jbagnara/wheatboard/README.md

# wheatboard

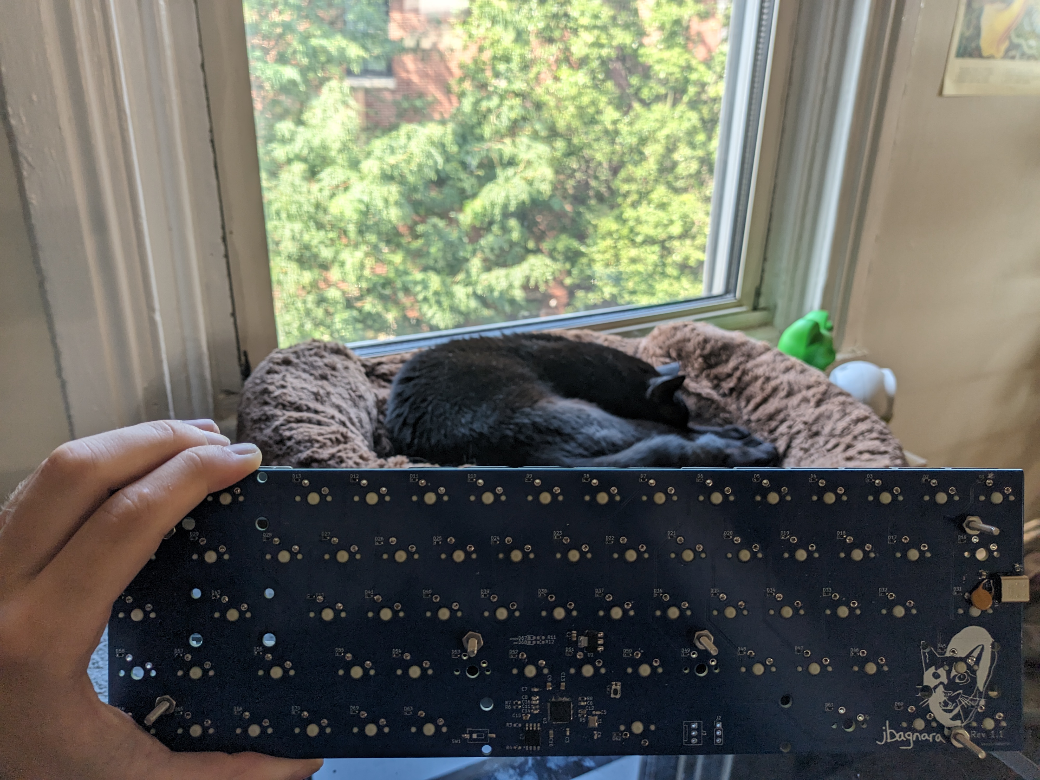
[picture p1: img/img0.jpg]

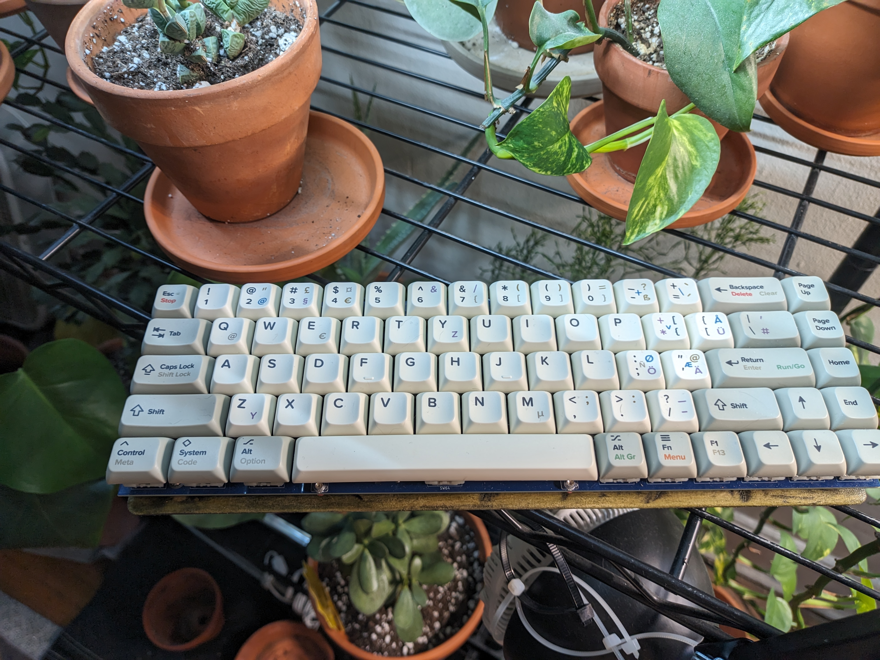
[picture p2: img/img3.jpg]

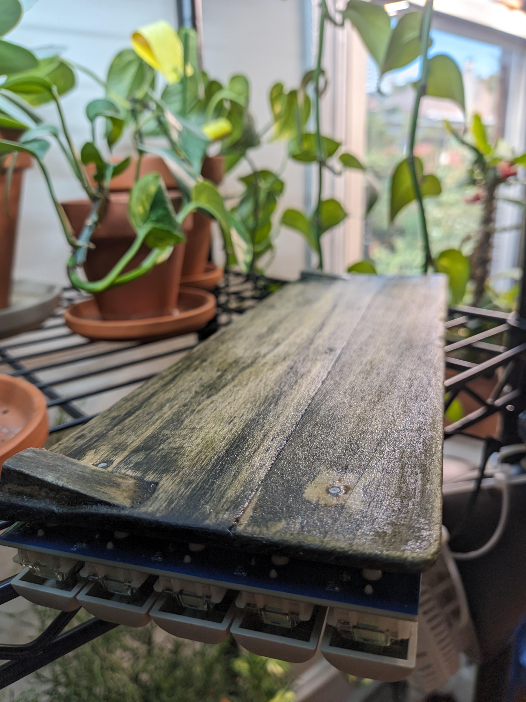
[picture p3: img/img2.jpg]

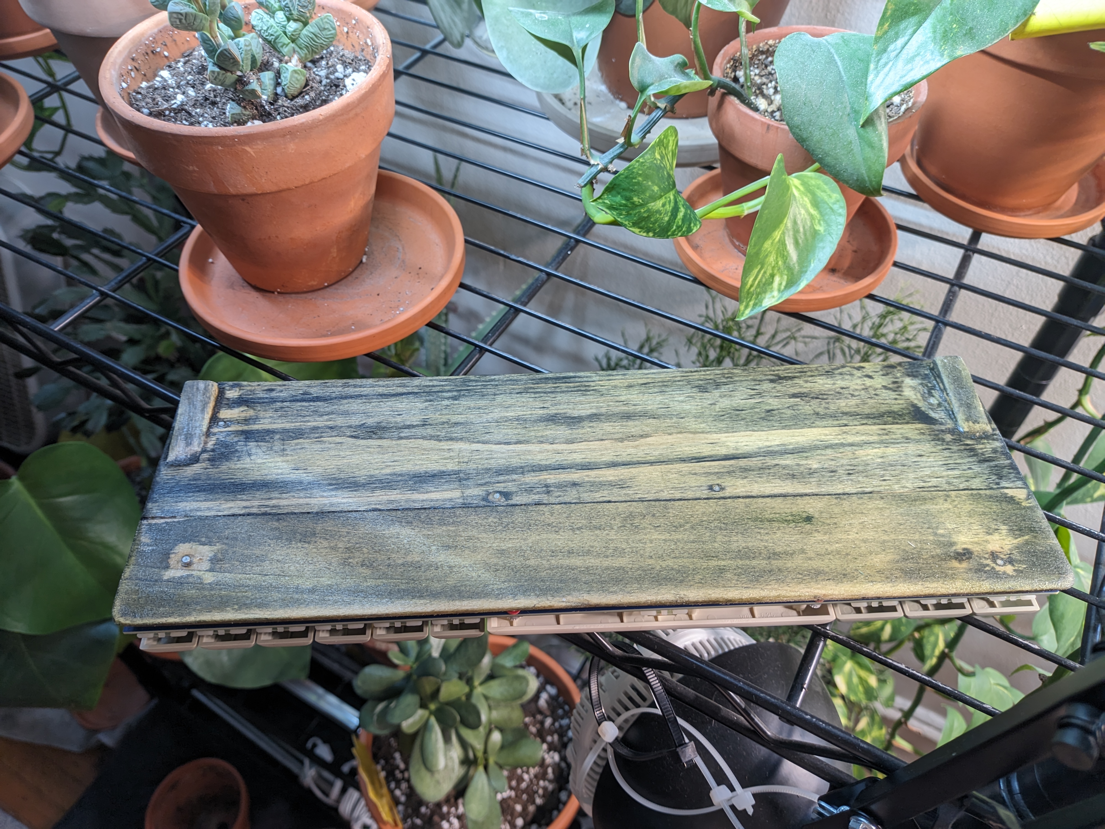
[picture p4: img/img4.jpg]
