jbagnara/wheatboard/kicad/keyboard.kicad_pcb

## KiCad design kicad/keyboard.kicad_pcb (2025-07-31)

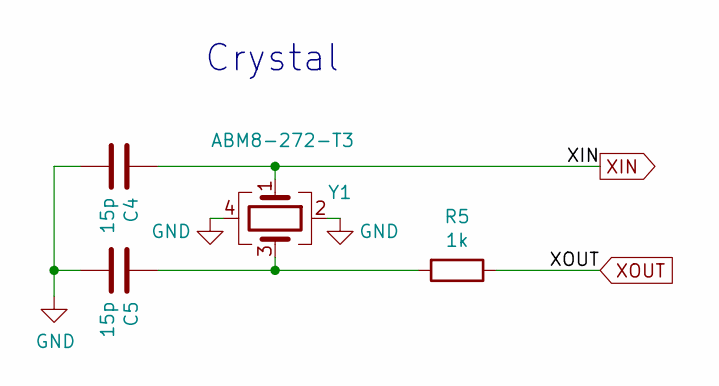
[picture p6: schematic oscillator.kicad_sch]

Parts:
C4, C5: 15p; C_0603_1608Metric
R5: 1k; R_0603_1608Metric
Y1: ABM8-272-T3; Crystal_SMD_3225-4Pin_3.2x2.5mm

Connections:
GND: C4.2, C5.2, Y1.2, Y1.4; also elsewhere on the board
unnamed: C5.1, R5.2, Y1.3
XIN: C4.1, Y1.1; also elsewhere on the board
XOUT: R5.1; also elsewhere on the board

Notes on the sheet:
Crystal

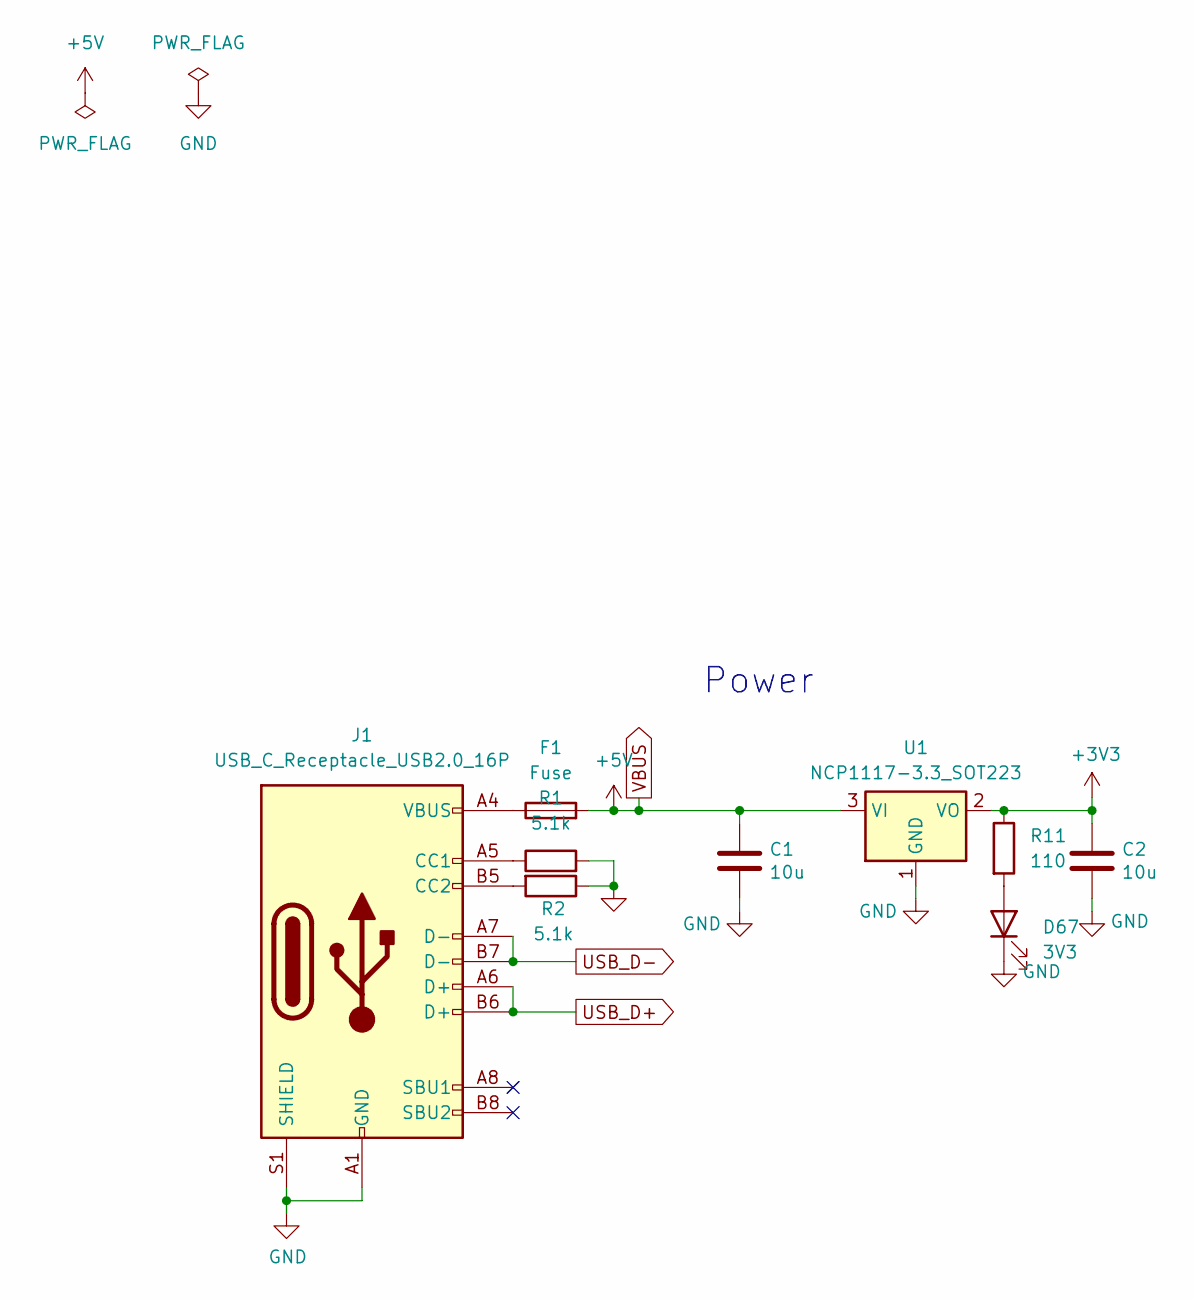
[picture p7: schematic power.kicad_sch]

Parts:
C1, C2: 10u; C_0805_2012Metric
D67: 3V3; LED_0603_1608Metric
F1: Fuse; Fuse_0603_1608Metric_Pad1.05x0.95mm_HandSolder
J1: USB_C_Receptacle_USB2.0_16P; USB_C_Receptacle_GCT_USB4085
R1, R2: 5.1k; R_0603_1608Metric
R11: 110; R_0603_1608Metric
U1: NCP1117-3.3_SOT223; SOT-223-3_TabPin2

Connections:
+3V3: C2.1, R11.1, U1.2 (VO); also elsewhere on the board
GND: C1.2, C2.2, D67.1 (K), J1.A1 (GND), J1.A12 (GND), J1.B1 (GND), J1.B12 (GND), J1.S1 (SHIELD), R1.2, R2.1, U1.1 (GND); also elsewhere on the board
unnamed: D67.2 (A), R11.2
unnamed: F1.1, J1.A4 (VBUS), J1.A9 (VBUS), J1.B4 (VBUS), J1.B9 (VBUS)
unnamed: J1.A5 (CC1), R1.1
unnamed: J1.B5 (CC2), R2.2
USB_D+: J1.A6 (D+), J1.B6 (D+); also elsewhere on the board
USB_D-: J1.A7 (D-), J1.B7 (D-); also elsewhere on the board
VBUS: C1.1, F1.2, U1.3 (VI)

Notes on the sheet:
Power

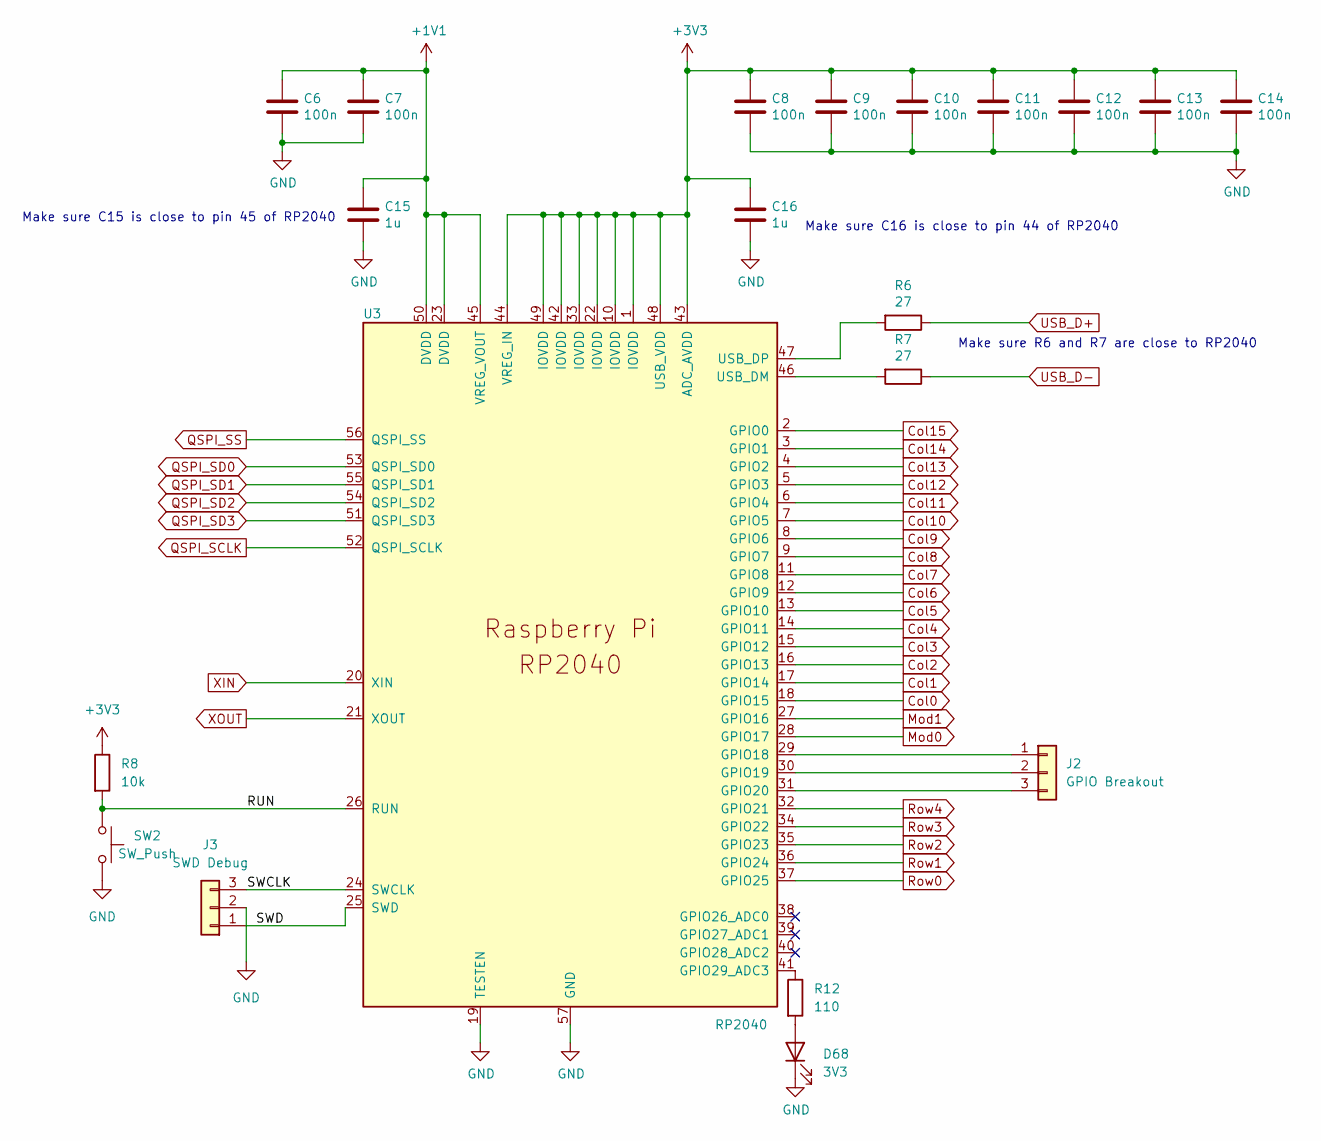
[picture p8: schematic mcu.kicad_sch]

Parts:
C6, C7, C8, C9, C10, C11, C12, C13, C14: 100n; C_0603_1608Metric
C15, C16: 1u; C_0603_1608Metric
D68: 3V3; LED_0603_1608Metric
J2: GPIO Breakout; PinHeader_1x03_P2.54mm_Vertical
J3: SWD Debug; FanPinHeader_1x03_P2.54mm_Vertical
R6, R7: 27; R_0603_1608Metric
R8: 10k; R_0603_1608Metric
R12: 110; R_0603_1608Metric
SW2: SW_Push; SW_Push_1P1T_NO_CK_KMR2
U3: RP2040; RP2040-QFN-56

Connections:
+1V1: C6.1, C7.1, C15.1, U3.23 (DVDD), U3.45 (VREG_VOUT), U3.50 (DVDD)
+3V3: C8.1, C9.1, C10.1, C11.1, C12.1, C13.1, C14.1, C16.1, R8.1, U3.1 (IOVDD), U3.10 (IOVDD), U3.22 (IOVDD), U3.33 (IOVDD), U3.42 (IOVDD), U3.43 (ADC_AVDD), U3.44 (VREG_IN), U3.48 (USB_VDD), U3.49 (IOVDD); also elsewhere on the board
/MCU/RUN: R8.2, SW2.1, U3.26 (RUN)
/MCU/SWCLK: J3.3, U3.24 (SWCLK)
/MCU/SWD: J3.1, U3.25 (SWD)
Col0: U3.18 (GPIO15); also elsewhere on the board
Col1: U3.17 (GPIO14); also elsewhere on the board
Col2: U3.16 (GPIO13); also elsewhere on the board
Col3: U3.15 (GPIO12); also elsewhere on the board
Col4: U3.14 (GPIO11); also elsewhere on the board
Col5: U3.13 (GPIO10); also elsewhere on the board
Col6: U3.12 (GPIO9); also elsewhere on the board
Col7: U3.11 (GPIO8); also elsewhere on the board
Col8: U3.9 (GPIO7); also elsewhere on the board
Col9: U3.8 (GPIO6); also elsewhere on the board
Col10: U3.7 (GPIO5); also elsewhere on the board
Col11: U3.6 (GPIO4); also elsewhere on the board
Col12: U3.5 (GPIO3); also elsewhere on the board
Col13: U3.4 (GPIO2); also elsewhere on the board
Col14: U3.3 (GPIO1); also elsewhere on the board
Col15: U3.2 (GPIO0); also elsewhere on the board
GND: C6.2, C7.2, C8.2, C9.2, C10.2, C11.2, C12.2, C13.2, C14.2, C15.2, C16.2, D68.1 (K), J3.2, SW2.2, U3.19 (TESTEN), U3.57 (GND); also elsewhere on the board
Mod0: U3.28 (GPIO17)
Mod1: U3.27 (GPIO16)
unnamed: D68.2 (A), R12.2
unnamed: J2.1, U3.29 (GPIO18)
unnamed: J2.2, U3.30 (GPIO19)
unnamed: J2.3, U3.31 (GPIO20)
unnamed: R12.1, U3.41 (GPIO29_ADC3)
unnamed: R7.2, U3.46 (USB_DM)
unnamed: R6.2, U3.47 (USB_DP)
QSPI_SCLK: U3.52 (QSPI_SCLK); also elsewhere on the board
QSPI_SD0: U3.53 (QSPI_SD0); also elsewhere on the board
QSPI_SD1: U3.55 (QSPI_SD1); also elsewhere on the board
QSPI_SD2: U3.54 (QSPI_SD2); also elsewhere on the board
QSPI_SD3: U3.51 (QSPI_SD3); also elsewhere on the board
QSPI_SS: U3.56 (QSPI_SS); also elsewhere on the board
Row0: U3.37 (GPIO25); also elsewhere on the board
Row1: U3.36 (GPIO24); also elsewhere on the board
Row2: U3.35 (GPIO23); also elsewhere on the board
Row3: U3.34 (GPIO22); also elsewhere on the board
Row4: U3.32 (GPIO21); also elsewhere on the board
USB_D+: R6.1; also elsewhere on the board
USB_D-: R7.1; also elsewhere on the board
XIN: U3.20 (XIN); also elsewhere on the board
XOUT: U3.21 (XOUT); also elsewhere on the board

Notes on the sheet:
Make sure C16 is close to pin 44 of RP2040
Make sure C15 is close to pin 45 of RP2040
Make sure R6 and R7 are close to RP2040

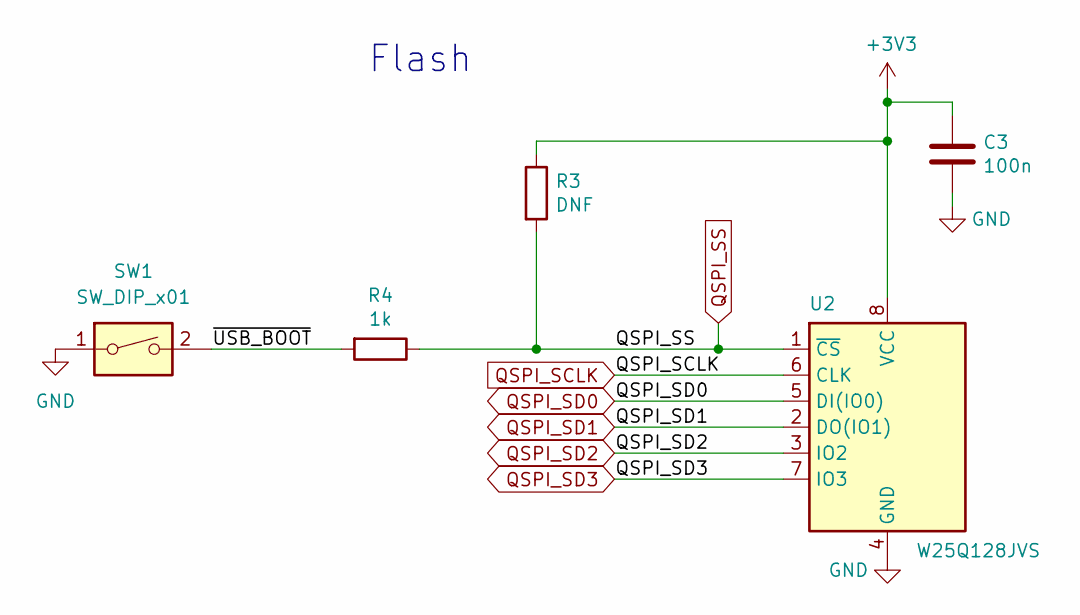
[picture p9: schematic flash.kicad_sch]

Parts:
C3: 100n; C_0603_1608Metric
R3: DNF; R_0603_1608Metric
R4: 1k; R_0603_1608Metric
SW1: SW_DIP_x01; SW_DIP_SPSTx01_Slide_6.7x4.1mm_W8.61mm_P2.54mm_LowProfile
U2: W25Q128JVS; SOIC-8_5.23x5.23mm_P1.27mm

Connections:
+3V3: C3.1, R3.1, U2.8 (VCC); also elsewhere on the board
/Flash/~USB_BOOT: R4.2, SW1.2
GND: C3.2, SW1.1, U2.4 (GND); also elsewhere on the board
QSPI_SCLK: U2.6 (CLK); also elsewhere on the board
QSPI_SD0: U2.5 (DI(IO0)); also elsewhere on the board
QSPI_SD1: U2.2 (DO(IO1)); also elsewhere on the board
QSPI_SD2: U2.3 (IO2); also elsewhere on the board
QSPI_SD3: U2.7 (IO3); also elsewhere on the board
QSPI_SS: R3.2, R4.1, U2.1 (~CS); also elsewhere on the board

Notes on the sheet:
Flash

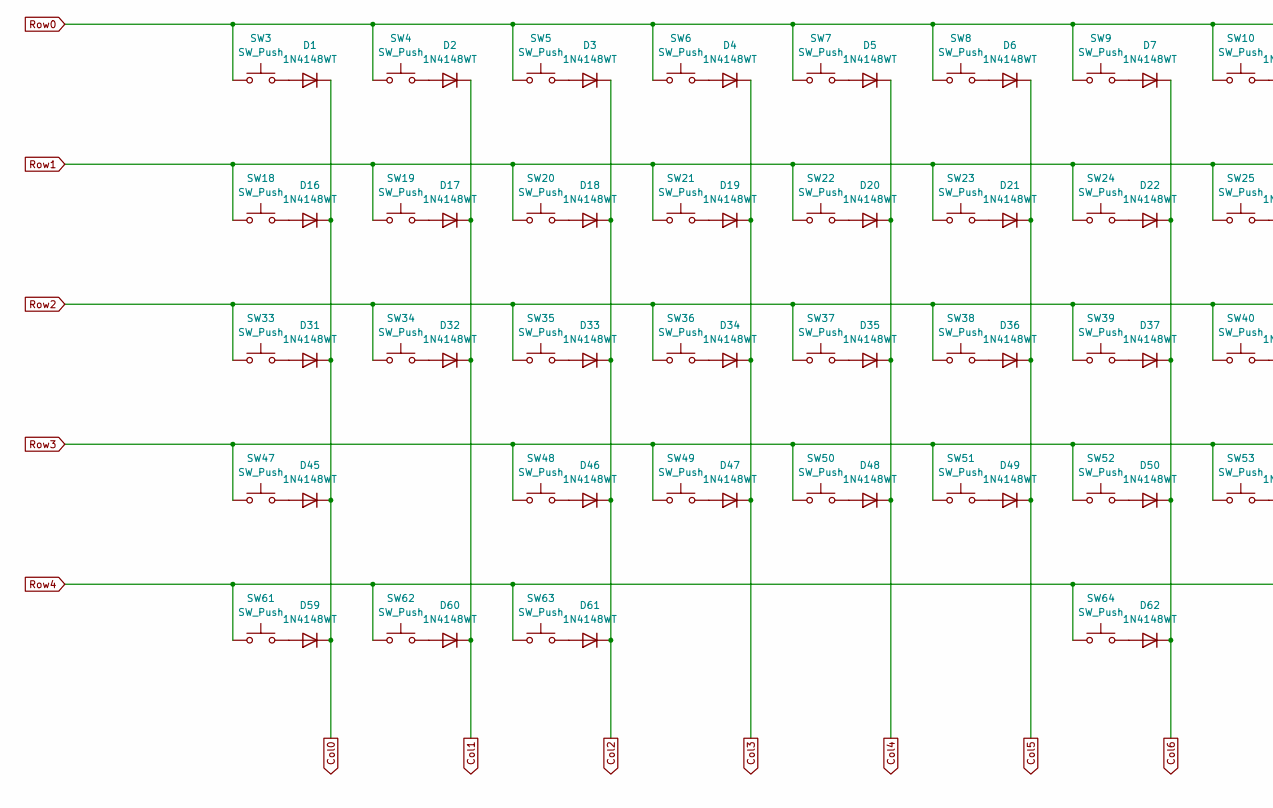
[picture p10: schematic switchmat.kicad_sch, part in row 1, column 1]

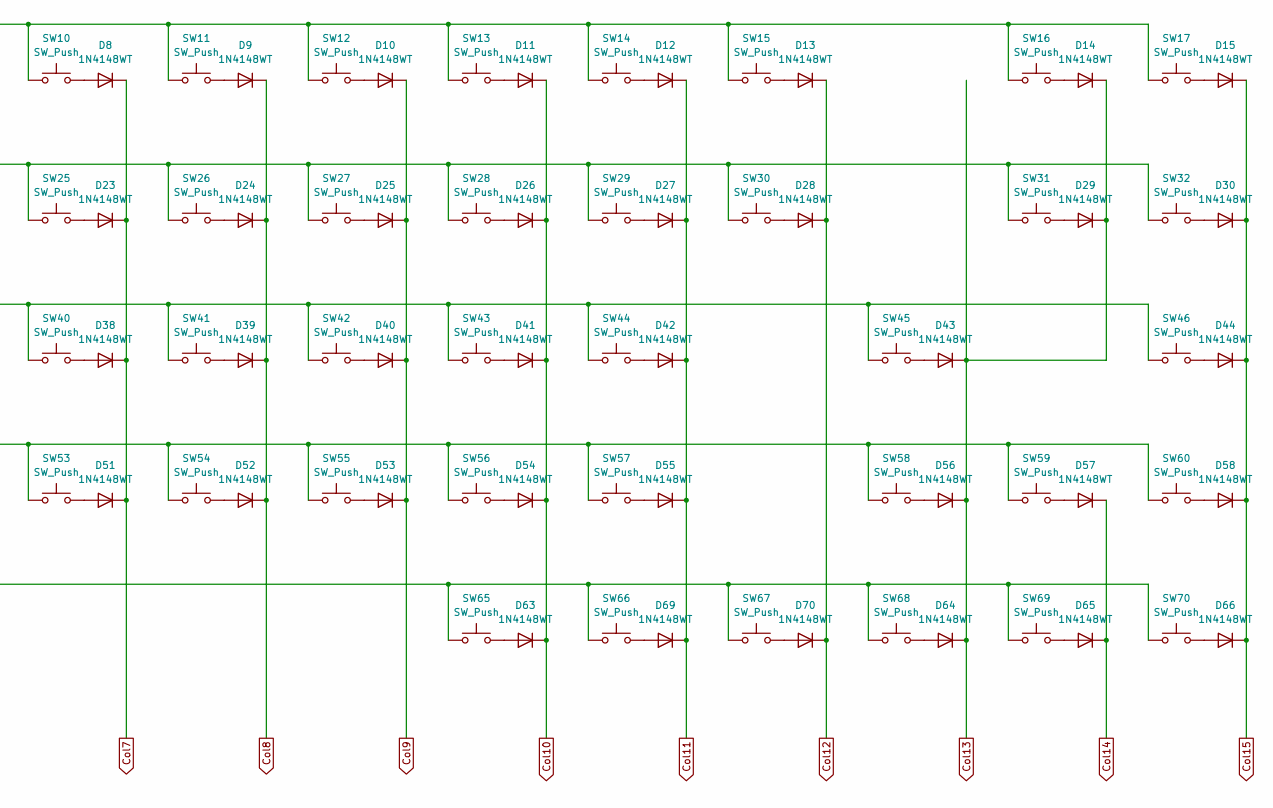
[picture p11: schematic switchmat.kicad_sch, part in row 1, column 2]

Parts:
D1, D2, D3, D4, D5, D6, D7, D8, D9, D10, D11, D12, D13, D14, D15, D16, D17, D18, D19, D20, D21, D22, D23, D24, D25, D26, D27, D28, D29, D30, D31, D32, D33, D34, D35, D36, D37, D38, D39, D40, D41, D42, D43, D44, D45, D46, D47, D48, D49, D50, D51, D52, D53, D54, D55, D56, D57, D58, D59, D60, D61, D62, D63, D64, D65, D66, D69, D70: 1N4148WT; D_SOD-523
SW3, SW4, SW5, SW6, SW7, SW8, SW9, SW10, SW11, SW12, SW13, SW14, SW15, SW16, SW17, SW19, SW20, SW21, SW22, SW23, SW24, SW25, SW26, SW27, SW28, SW29, SW30, SW31, SW32, SW34, SW35, SW36, SW37, SW38, SW39, SW40, SW41, SW42, SW43, SW44, SW46, SW48, SW49, SW50, SW51, SW52, SW53, SW54, SW55, SW56, SW57, SW59, SW60, SW65, SW66, SW67, SW68, SW69, SW70: SW_Push; SW_Cherry_MX_1.00u_PCB
SW18: SW_Push; SW_Cherry_MX_1.50u_PCB
SW33, SW58: SW_Push; SW_Cherry_MX_Plate_1.75u
SW45, SW47: SW_Push; SW_Cherry_MX_2.25u_PCB
SW61, SW62, SW63: SW_Push; SW_Cherry_MX_1.25u_PCB
SW64: SW_Push; SW_Cherry_MX_6.25u_PCB

Connections:
Col0: D1.1 (K), D16.1 (K), D31.1 (K), D45.1 (K), D59.1 (K); also elsewhere on the board
Col1: D2.1 (K), D17.1 (K), D32.1 (K), D60.1 (K); also elsewhere on the board
Col2: D3.1 (K), D18.1 (K), D33.1 (K), D46.1 (K), D61.1 (K); also elsewhere on the board
Col3: D4.1 (K), D19.1 (K), D34.1 (K), D47.1 (K); also elsewhere on the board
Col4: D5.1 (K), D20.1 (K), D35.1 (K), D48.1 (K); also elsewhere on the board
Col5: D6.1 (K), D21.1 (K), D36.1 (K), D49.1 (K); also elsewhere on the board
Col6: D7.1 (K), D22.1 (K), D37.1 (K), D50.1 (K), D62.1 (K); also elsewhere on the board
Col7: D8.1 (K), D23.1 (K), D38.1 (K), D51.1 (K); also elsewhere on the board
Col8: D9.1 (K), D24.1 (K), D39.1 (K), D52.1 (K); also elsewhere on the board
Col9: D10.1 (K), D25.1 (K), D40.1 (K), D53.1 (K); also elsewhere on the board
Col10: D11.1 (K), D26.1 (K), D41.1 (K), D54.1 (K), D63.1 (K); also elsewhere on the board
Col11: D12.1 (K), D27.1 (K), D42.1 (K), D55.1 (K), D69.1 (K); also elsewhere on the board
Col12: D13.1 (K), D28.1 (K), D70.1 (K); also elsewhere on the board
Col13: D14.1 (K), D29.1 (K), D43.1 (K), D56.1 (K), D64.1 (K); also elsewhere on the board
Col14: D57.1 (K), D65.1 (K); also elsewhere on the board
Col15: D15.1 (K), D30.1 (K), D44.1 (K), D58.1 (K), D66.1 (K); also elsewhere on the board
unnamed: D1.2 (A), SW3.2
unnamed: D2.2 (A), SW4.2
unnamed: D3.2 (A), SW5.2
unnamed: D4.2 (A), SW6.2
unnamed: D5.2 (A), SW7.2
unnamed: D6.2 (A), SW8.2
unnamed: D7.2 (A), SW9.2
unnamed: D8.2 (A), SW10.2
unnamed: D9.2 (A), SW11.2
unnamed: D10.2 (A), SW12.2
unnamed: D11.2 (A), SW13.2
unnamed: D12.2 (A), SW14.2
unnamed: D13.2 (A), SW15.2
unnamed: D14.2 (A), SW16.2
unnamed: D15.2 (A), SW17.2
unnamed: D16.2 (A), SW18.2
unnamed: D17.2 (A), SW19.2
unnamed: D18.2 (A), SW20.2
unnamed: D19.2 (A), SW21.2
unnamed: D20.2 (A), SW22.2
unnamed: D21.2 (A), SW23.2
unnamed: D22.2 (A), SW24.2
unnamed: D23.2 (A), SW25.2
unnamed: D24.2 (A), SW26.2
unnamed: D25.2 (A), SW27.2
unnamed: D26.2 (A), SW28.2
unnamed: D27.2 (A), SW29.2
unnamed: D28.2 (A), SW30.2
unnamed: D29.2 (A), SW31.2
unnamed: D30.2 (A), SW32.2
unnamed: D31.2 (A), SW33.2
unnamed: D32.2 (A), SW34.2
unnamed: D33.2 (A), SW35.2
unnamed: D34.2 (A), SW36.2
unnamed: D35.2 (A), SW37.2
unnamed: D36.2 (A), SW38.2
unnamed: D37.2 (A), SW39.2
unnamed: D38.2 (A), SW40.2
unnamed: D39.2 (A), SW41.2
unnamed: D40.2 (A), SW42.2
unnamed: D41.2 (A), SW43.2
unnamed: D42.2 (A), SW44.2
unnamed: D43.2 (A), SW45.2
unnamed: D44.2 (A), SW46.2
unnamed: D45.2 (A), SW47.2
unnamed: D46.2 (A), SW48.2
unnamed: D47.2 (A), SW49.2
unnamed: D48.2 (A), SW50.2
unnamed: D49.2 (A), SW51.2
unnamed: D50.2 (A), SW52.2
unnamed: D51.2 (A), SW53.2
unnamed: D52.2 (A), SW54.2
unnamed: D53.2 (A), SW55.2
unnamed: D54.2 (A), SW56.2
unnamed: D55.2 (A), SW57.2
unnamed: D56.2 (A), SW58.2
unnamed: D57.2 (A), SW59.2
unnamed: D58.2 (A), SW60.2
unnamed: D59.2 (A), SW61.2
unnamed: D60.2 (A), SW62.2
unnamed: D61.2 (A), SW63.2
unnamed: D62.2 (A), SW64.2
unnamed: D63.2 (A), SW65.2
unnamed: D64.2 (A), SW68.2
unnamed: D65.2 (A), SW69.2
unnamed: D66.2 (A), SW70.2
unnamed: D69.2 (A), SW66.2
unnamed: D70.2 (A), SW67.2
Row0: SW3.1, SW4.1, SW5.1, SW6.1, SW7.1, SW8.1, SW9.1, SW10.1, SW11.1, SW12.1, SW13.1, SW14.1, SW15.1, SW16.1, SW17.1; also elsewhere on the board
Row1: SW18.1, SW19.1, SW20.1, SW21.1, SW22.1, SW23.1, SW24.1, SW25.1, SW26.1, SW27.1, SW28.1, SW29.1, SW30.1, SW31.1, SW32.1; also elsewhere on the board
Row2: SW33.1, SW34.1, SW35.1, SW36.1, SW37.1, SW38.1, SW39.1, SW40.1, SW41.1, SW42.1, SW43.1, SW44.1, SW45.1, SW46.1; also elsewhere on the board
Row3: SW47.1, SW48.1, SW49.1, SW50.1, SW51.1, SW52.1, SW53.1, SW54.1, SW55.1, SW56.1, SW57.1, SW58.1, SW59.1, SW60.1; also elsewhere on the board
Row4: SW61.1, SW62.1, SW63.1, SW64.1, SW65.1, SW66.1, SW67.1, SW68.1, SW69.1, SW70.1; also elsewhere on the board

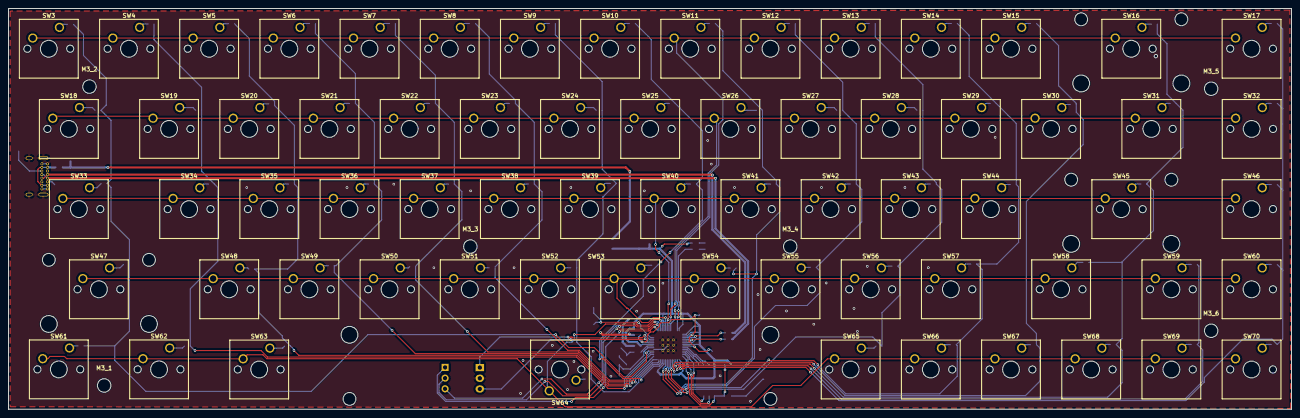
[picture p12: board keyboard.kicad_pcb from above]

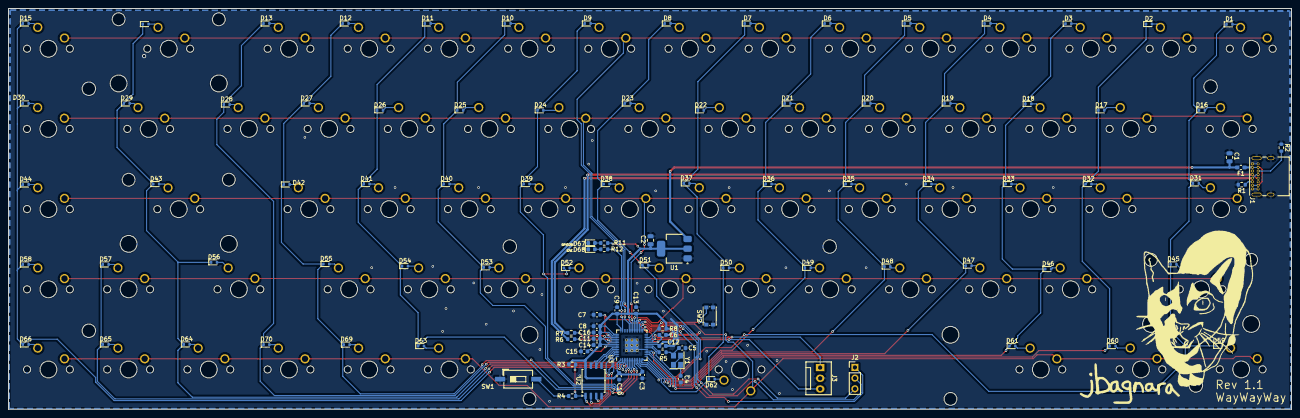
[picture p13: board keyboard.kicad_pcb from below]

Board: 2 copper layers, 304.8 x 95.2 mm, 180 parts (106 on the bottom side), 119 nets.

Other parts of the board:
M3_1, M3_2, M3_3, M3_4, M3_5, M3_6: MountingHole_3.2mm_M3
