jbagnara/wheatboard/(commit log)

2025-07-31 add kicad files
    [flash.kicad_sch, keyboard.kicad_pcb, keyboard.kicad_sch, mcu.kicad_sch, oscillator.kicad_sch, power.kicad_sch, switchmat.kicad_sch]
2025-07-31 add parts list
    [BOM.csv]
2025-07-31 fix number of switches
    [BOM.csv]
